xaxaxa-dev/vna/pictures/all.jpg

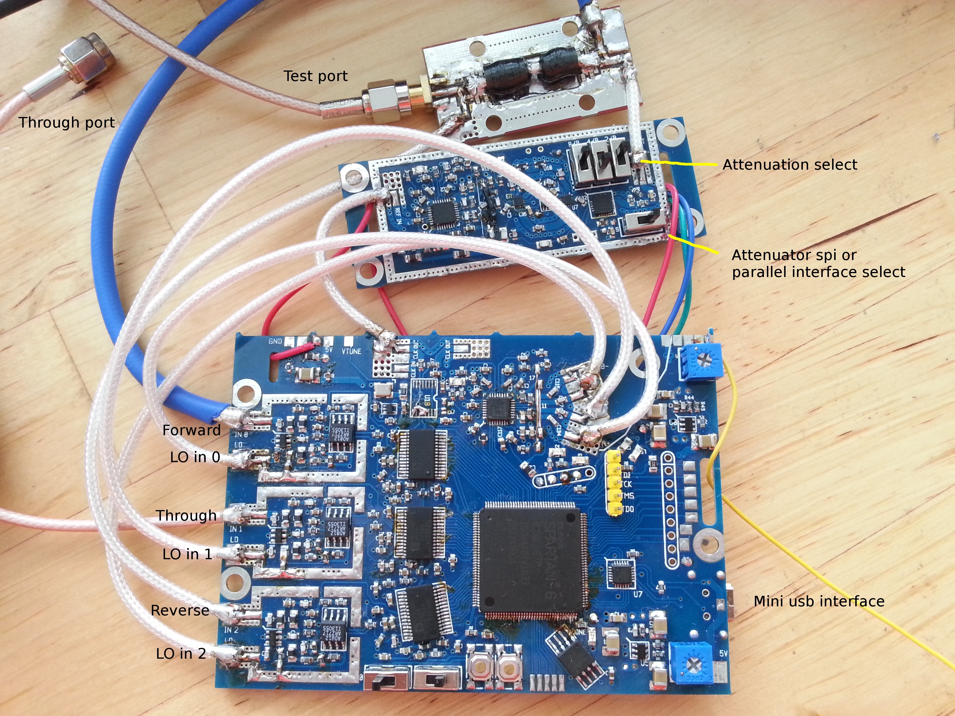
pictures/all.jpg
