xaxaxa-dev/vna/pictures/cmp_attenuator_200_2180.png

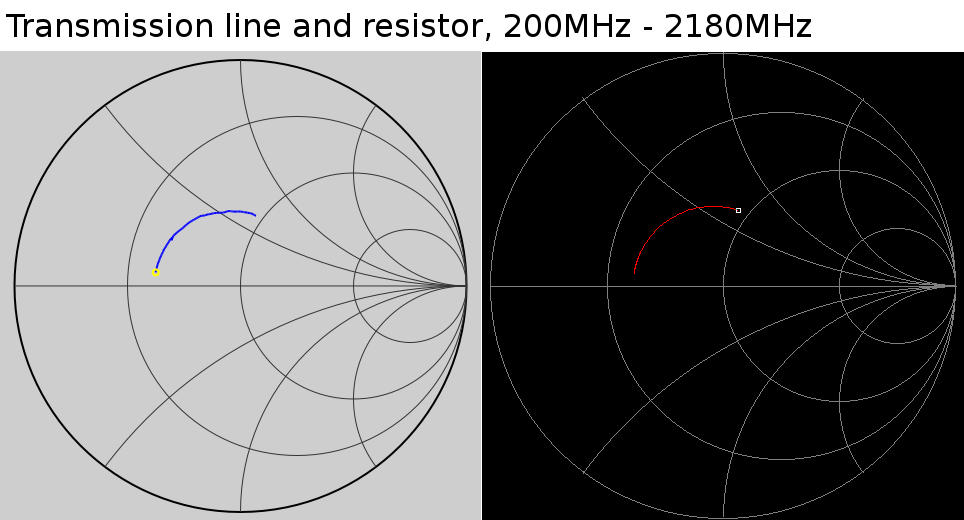
pictures/cmp_attenuator_200_2180.png
