xaxaxa-dev/vna/pictures/cmp_open_stub_200_2180.png

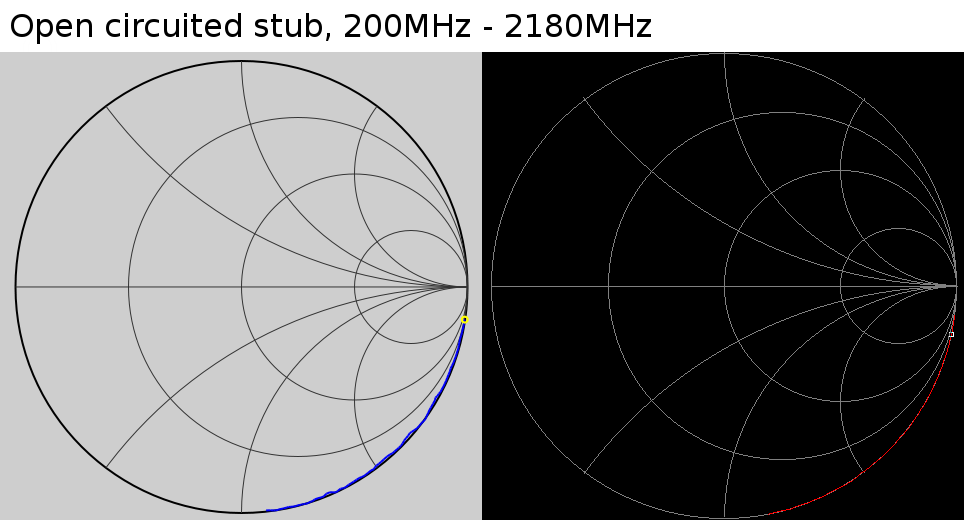
pictures/cmp_open_stub_200_2180.png
