xaxaxa-dev/vna/pictures/coupler_top.png

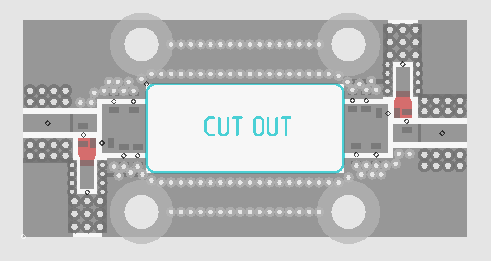
pictures/coupler_top.png
