xaxaxa-dev/vna/pictures/drift_100C_short_200_2180.png

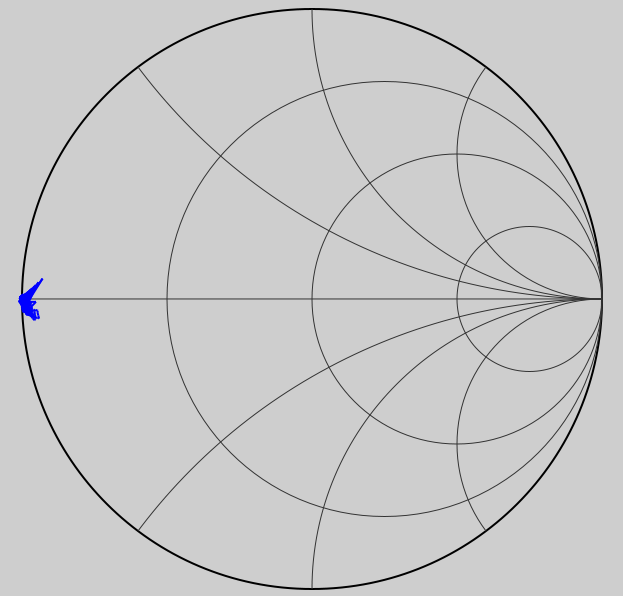
pictures/drift_100C_short_200_2180.png
