xaxaxa-dev/vna/pictures/drift_resistor_200_2180.png

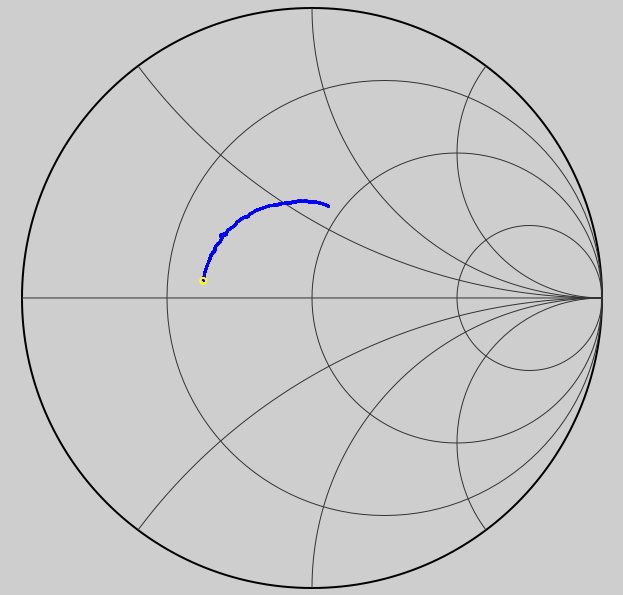
pictures/drift_resistor_200_2180.png
