xaxaxa-dev/vna/pictures/main_top.png

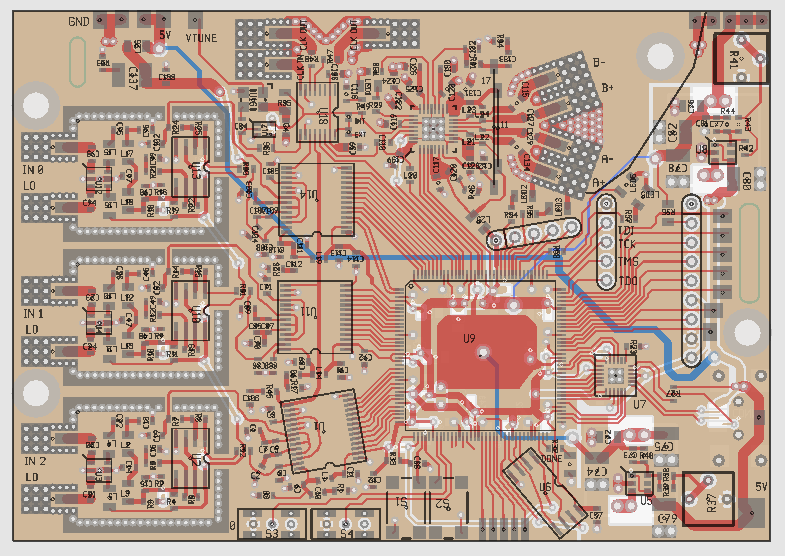
pictures/main_top.png
