xaxaxa-dev/vna/pictures/screenshot_antenna.png

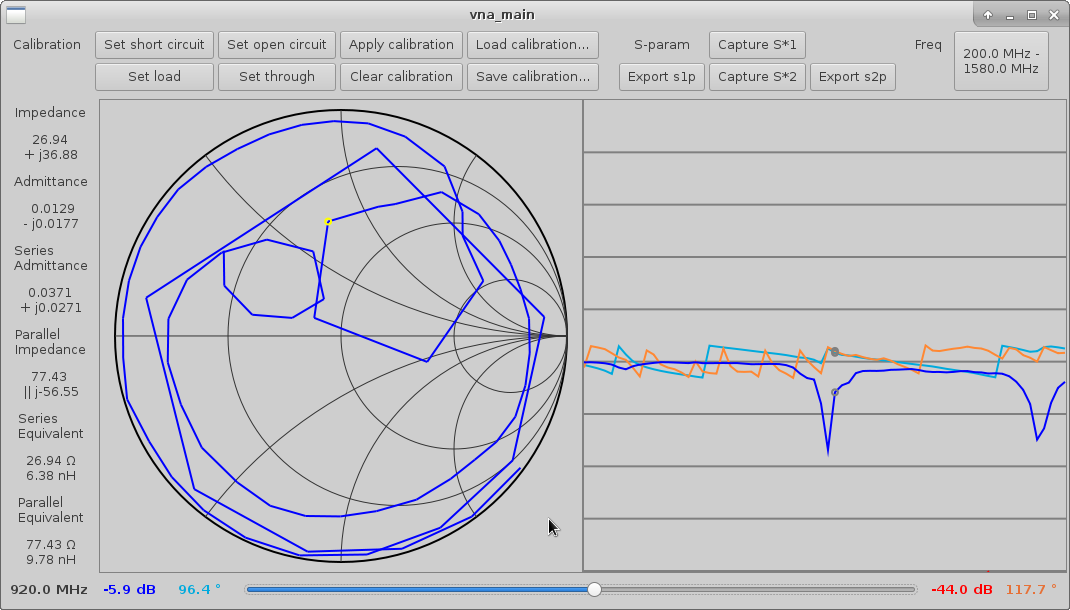
pictures/screenshot_antenna.png
