xaxaxa-dev/vna/pictures/screenshot_open_stub.png

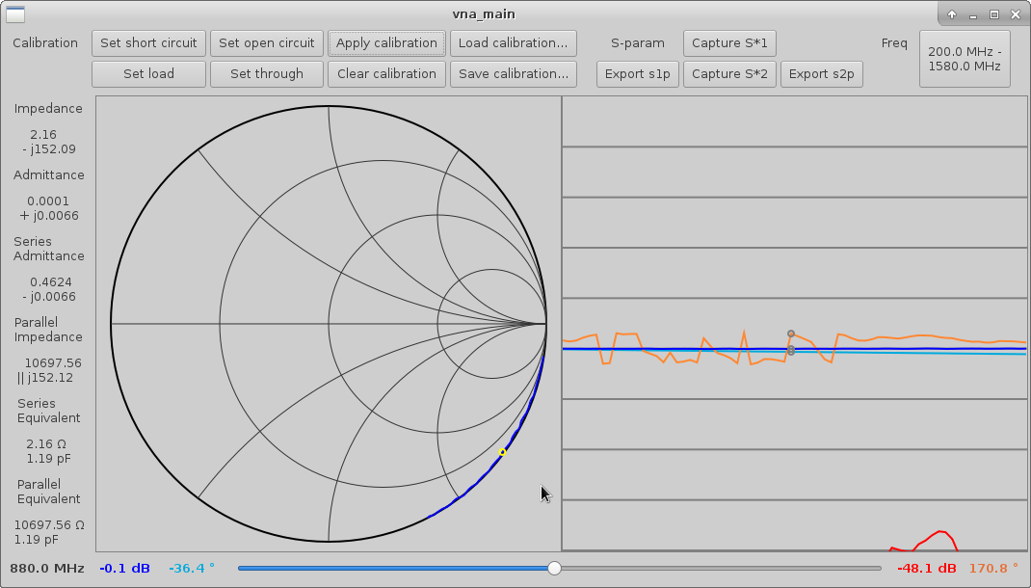
pictures/screenshot_open_stub.png
