xaxaxa-dev/vna/pictures/screenshot_pa_900.png

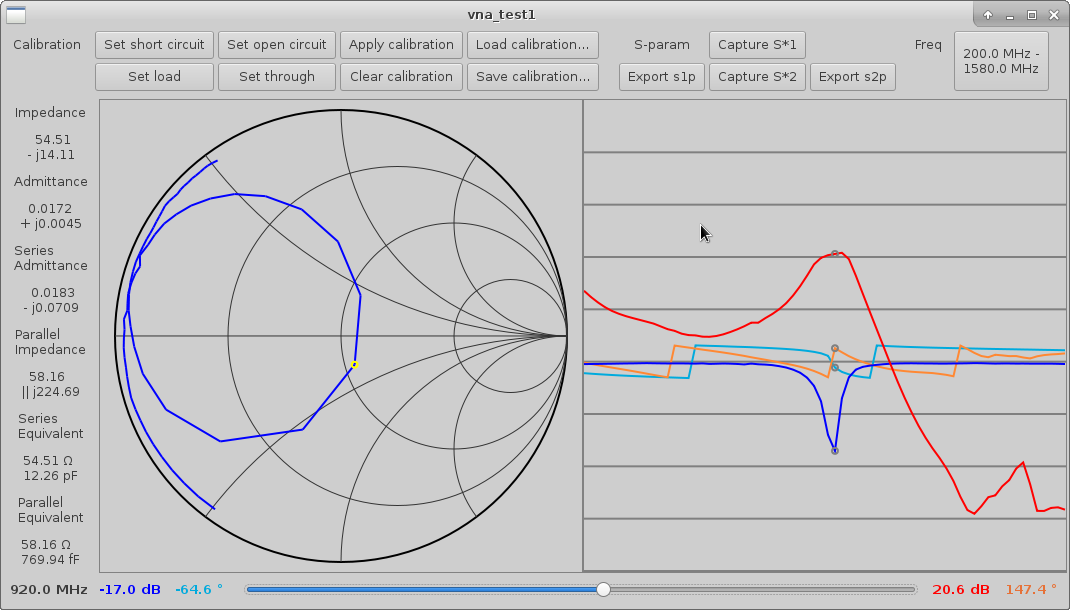
pictures/screenshot_pa_900.png
