xaxaxa-dev/vna/pictures/tx_top.png

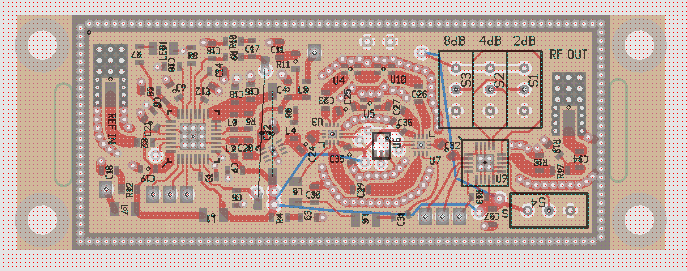
pictures/tx_top.png
