xaxaxa-dev/vna/enclosure/front_back_panel.fcstd

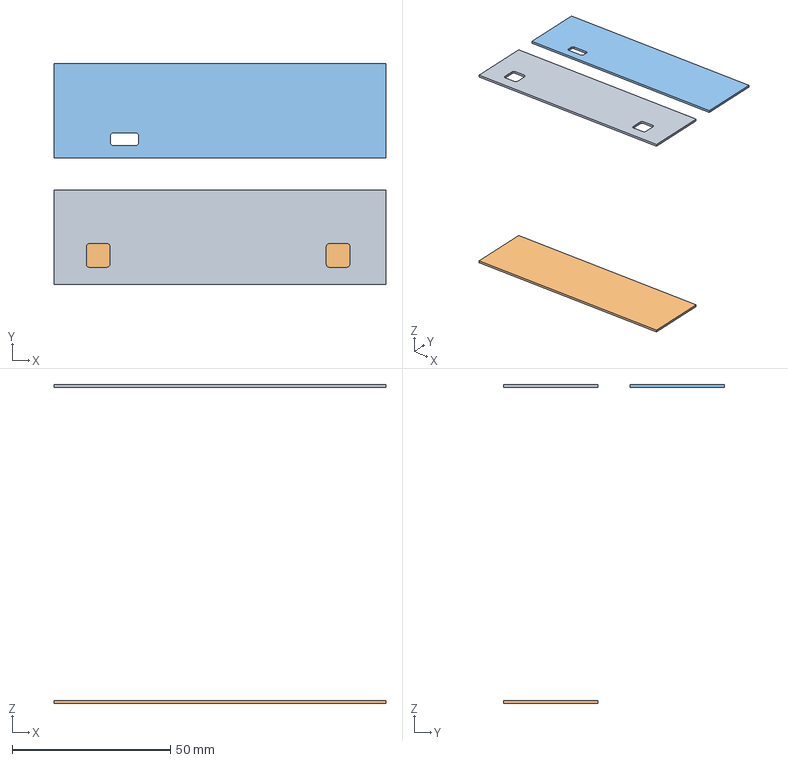
[picture p21: CAD file, 2018-03-27]
enclosure/front_back_panel.fcstd
105.0 x 70.0 x 101.0 mm
cube_back
