xaxaxa-dev/vna/(threads)

Thread 4 (2018-06-03):

HW and SW review

jkassot, 2018-06-03:
I received the XaVNA in Netherlands and tested it with a WG antenna at 2700-3000 MHz.

1. The  board seems to be of high built quality, however it appears to be a problem with the port SMA connectors and the aluminum housing. As the connectors are not secured on the enclosure, any movement of the measurement cables is transferred to the edge SMA connectors and to the board itself making the measurements jump around by 2-3 db or more. Not good for consistency. Is this issue has also been identified above as "Port Length Extension Support"? Or refers to electrical extension of the ports? It should have an easy fix at the following production batch.

2. I used the device with a Windows 10 DELL notebook. The SW is intuitive, easy to use and fast responding. However, I could not find a way to adjust the vertical scale in order to zoom into the measurements as the full dynamic range is always being displayed. That restricted the displayed accuracy to a few db. In this way could not take advantage of the measurement precision. It would be absolutely necessary to provide the option to adjust the min and the max value of the vertical scale (mainly in db and secondary in deg).

3. The measurement export function  is available only for Touchstone format and thus a specialized viewer is required to view and manipulate the measurements . It would be very helpful if there could be an output of the measurements in db and deg units as a generic Delimited Text File (DTF) that could be easily imported into Excel, MATLAB or any other application. Screen exports as .jpg or .pdf would also be helpful although there is always the workaround of screen capture.

4. The device applications would be vastly expanded if the Transmit and Receive functions could be used independently as a CW  RF generator (adjust  frequency and power) and as a calibrated Spectrum Analyzer and Peak Power meter (using the cursor). I think that almost all the code is there, just need some user interface.

Thanks for a really good product with a potential to become much better and versatile.

xaxaxa, 2018-06-04:
(1) i've noticed this issue after the first batch, and the current plan is to switch to a bulkhead sma connector that is screwed to the enclosure for later units (the full two port version already has this implemented); for the current units a workaround is to stuff some double sided tape between the board and enclosure cover plate so that it fits tightly. Thanks for bringing this up.
(2) the software is still under development and i'm working to implement those features asap
(3) i've added a todo for this one
(4) that is possible but might require updates to the firmware, since currently the device only sends values after the integrate-and-dump unit; i'm going to add a register that allows you to switch to raw adc data output, and add some facilities in libxavna to support this.

Thanks

Thread 8 (2018-06-05):

Time/Space vs Frequency VNA measurements

jkassot, 2018-06-05:
There are several cases where VNA measurements need to be taken at a single frequency over time or space instead of frequency. For example, when testing a multi-element (phased array) antenna and need to check amplitude and phase (S21) from feed point to each element and/or reverse.
Would it be possible to select first a single Frequency and Power setting and then select:
 (a)  either a Time period of measurement (in Seconds)
or (b) a number of discrete measurement steps (and advance manually from one to next) ?
You would then need to rescale the x-axis to accommodate the selected time period (in sec) or the number of discrete steps.
You could also ask user  specify the number of samples to average at each step.
Finally, save the measurement to a text delimited file format for further processing, like Near-to-Far field transformation by MATLAB.
If such a measurement mode could be possible, would open  for xaVNA a whole new range of applications that are not found at any low-cost VNAs.

xaxaxa, 2018-07-08:
The way the UI code is structured right now it would be difficult to implement an axis other than frequency, but I think this is a good use case for libxavna; you can use the C api: https://github.com/xaxaxa-dev/vna/tree/master/libxavna and just skip frequency sweeping. For the plotting there is a minimal example using QT graphs here: https://github.com/xaxaxa-dev/vna/tree/master/vna_diagtool which can be a starting point

cbalint13, 2018-11-22:
I believe that by exporting some API of xaVNA to some higer level languages e.g. python would be wiser and would cover more universal scenarios.

  Some small script examples (e.g. python)  would allow users to craft their own custom workflow and export measurments as they wish. Perhaps even connect with libs like matplotlib for graph out custom data in any flavour.

  I am willing to contribute a wrapper to python for some basic functions with some basic ilustrative usage examples but need first cmake infrastructure to ease the process of wrapping. See PR #17.

jkassot, 2019-05-16:
Are there any developments with regards to a Python wrapper for the C/C++ libraries? That would help a lot.

cbalint13, 2019-05-16:
On Thu, May 16, 2019 at 5:04 PM jkassot <notifications@github.com> wrote:

> Are there any developments with regards to a Python wrapper for the C/C++
> libraries? That would help a lot.
>

Hi Jkassot,

I work in progress on that, ETA ~1 month and will be done.

jkassot, 2019-05-16:
Fantastic!
Thanks!

On Thu, May 16, 2019 at 4:30 PM Balint Cristian <notifications@github.com>
wrote:

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

jkassot, 2019-08-02:
Any update on the python library by cbalint13?

Thread 15 (2018-10-27):

any way to stretch low end down to ~75MHz?

akohlsmith, 2018-10-27:
This is a fascinating project, thank you for your hard work!

I am wondering if it is possible to tweak the component selection to extend the low end down to include the broadcast FM range (88-108MHz), as I'd like to experiment with some filters in that area. Is such a thing possible with this design?

xaxaxa, 2018-10-31:
It's possible; the two synthesizers (adf4350) need to be replaced with adf4351 which will bring lower frequency limit down to 35MHz. There are plans to switch to adf4351 by default in an upcoming hardware revision.

kf4mot, 2018-12-07:
Any estimate on when the 35MHz version will be available?

xaxaxa, 2018-12-09:
@kf4mot probably by Q2 2019

Closed 2018-10-31.

Thread 16 (2018-10-31):

Directional coupler detail

akohlsmith, 2018-10-31:
Is there any documentation on the directional coupler? It looks like some kind of large ferrite over part of the board, but I can't see any information other than that the PCB has a stripline.

xaxaxa, 2018-11-03:
it's a resistive bridge plus a balun, similar to the coupler used here: http://hforsten.com/improved-homemade-vna.html

Thread 19 (2018-12-13):

Any plans for a version with increased freq?

kf4mot, 2018-12-13:
Ideally up to 6 GHz+

xaxaxa, 2018-12-20:
None at the moment, but there is another open source VNA design that can go up to 6GHz: http://hforsten.com/improved-homemade-vna.html

kf4mot, 2018-12-21:
Or this may be a viable solution if freq. is scaled up. I probably even have most of the mixers, oscillator, and filters in my junk box.

Closed 2018-12-20.

Thread 20 (2019-01-14):

Crash when applying SOLT UXYZ or modified UXYZ calibration

Rodentia, 2019-01-14:
App crash on Mac and Windows when applying SOLT UXYZ or modified UXYZ calibration data.

Process:               vna_qt [62307]
Path:                  /Applications/vna_qt.app/Contents/MacOS/vna_qt
Identifier:            vna_qt
Version:               0
Code Type:             X86-64 (Native)
Parent Process:        ??? [1]
Responsible:           vna_qt [62307]
User ID:               501

Date/Time:             2019-01-14 15:35:06.379 -0800
OS Version:            Mac OS X 10.14.1 (18B2107)
Report Version:        12
Bridge OS Version:     3.1 (16P1582)
Anonymous UUID:        874C6354-2402-A038-F2C8-536EF4AFFF94

Sleep/Wake UUID:       1F95E6F7-4F14-4962-8174-6D0DD3298828

Time Awake Since Boot: 1900000 seconds
Time Since Wake:       26000 seconds

System Integrity Protection: enabled

Crashed Thread:        0  Dispatch queue: com.apple.main-thread

Exception Type:        EXC_CRASH (SIGABRT)
Exception Codes:       0x0000000000000000, 0x0000000000000000
Exception Note:        EXC_CORPSE_NOTIFY

Application Specific Information:
abort() called
terminating with uncaught exception of type std::runtime_error: matrix rank is not full! should be 4, is 3

Thread 0 Crashed:: Dispatch queue: com.apple.main-thread
0   libsystem_kernel.dylib        	0x00007fff7eeccb86 __pthread_kill + 10
1   libsystem_pthread.dylib       	0x00007fff7ef82c50 pthread_kill + 285
2   libsystem_c.dylib             	0x00007fff7ee361c9 abort + 127
3   libc++abi.dylib               	0x00007fff7c4b8231 abort_message + 231
4   libc++abi.dylib               	0x00007fff7c4b83b5 default_terminate_handler() + 241
5   libobjc.A.dylib               	0x00007fff7dcc1c8f _objc_terminate() + 105
6   libc++abi.dylib               	0x00007fff7c4c3dfe std::__terminate(void (*)()) + 8
7   libc++abi.dylib               	0x00007fff7c4b786e __cxa_rethrow + 99
8   libobjc.A.dylib               	0x00007fff7dcbfb6e objc_exception_rethrow + 40
9   com.apple.CoreFoundation      	0x00007fff51baaac3 CFRunLoopRunSpecific + 618
10  com.apple.HIToolbox           	0x00007fff50e43b35 RunCurrentEventLoopInMode + 293
11  com.apple.HIToolbox           	0x00007fff50e43774 ReceiveNextEventCommon + 371
12  com.apple.HIToolbox           	0x00007fff50e435e8 _BlockUntilNextEventMatchingListInModeWithFilter + 64
13  com.apple.AppKit              	0x00007fff4f0ffeb7 _DPSNextEvent + 997
14  com.apple.AppKit              	0x00007fff4f0fec56 -[NSApplication(NSEvent) _nextEventMatchingEventMask:untilDate:inMode:dequeue:] + 1362
15  com.apple.AppKit              	0x00007fff4f0f8cb9 -[NSApplication run] + 699
16  libqcocoa.dylib               	0x00000001050873ad 0x10505e000 + 168877
17  org.qt-project.QtCore         	0x0000000102fa9a72 QEventLoop::exec(QFlags<QEventLoop::ProcessEventsFlag>) + 418
18  org.qt-project.QtCore         	0x0000000102fae692 QCoreApplication::exec() + 402
19  com.yourcompany.vna-qt        	0x0000000101f7a94f main + 383
20  libdyld.dylib                 	0x00007fff7ed8e08d start + 1

Thread 1:: com.apple.NSEventThread
0   libsystem_kernel.dylib        	0x00007fff7eec6c2a mach_msg_trap + 10
1   libsystem_kernel.dylib        	0x00007fff7eec7174 mach_msg + 60
2   com.apple.CoreFoundation      	0x00007fff51babda2 __CFRunLoopServiceMachPort + 337
3   com.apple.CoreFoundation      	0x00007fff51bab2f1 __CFRunLoopRun + 1654
4   com.apple.CoreFoundation      	0x00007fff51baaa28 CFRunLoopRunSpecific + 463
5   com.apple.AppKit              	0x00007fff4f108add _NSEventThread + 160
6   libsystem_pthread.dylib       	0x00007fff7ef80339 _pthread_body + 126
7   libsystem_pthread.dylib       	0x00007fff7ef832a7 _pthread_start + 70
8   libsystem_pthread.dylib       	0x00007fff7ef7f445 thread_start + 13

Thread 2:: Dispatch queue: NSCGSDisableUpdates
0   libsystem_kernel.dylib        	0x00007fff7eec6c2a mach_msg_trap + 10
1   libsystem_kernel.dylib        	0x00007fff7eec7174 mach_msg + 60
2   com.apple.SkyLight            	0x00007fff77cb7c37 CGSUpdateManager::enable_updates_common() + 539
3   com.apple.SkyLight            	0x00007fff77c5b07f CGSUpdateManager::enable_update(unsigned long long) + 317
4   libdispatch.dylib             	0x00007fff7ed3ed53 _dispatch_call_block_and_release + 12
5   libdispatch.dylib             	0x00007fff7ed3fdcf _dispatch_client_callout + 8
6   libdispatch.dylib             	0x00007fff7ed46124 _dispatch_lane_serial_drain + 618
7   libdispatch.dylib             	0x00007fff7ed46bdc _dispatch_lane_invoke + 388
8   libdispatch.dylib             	0x00007fff7ed4f090 _dispatch_workloop_worker_thread + 603
9   libsystem_pthread.dylib       	0x00007fff7ef7f63c _pthread_wqthread + 409
10  libsystem_pthread.dylib       	0x00007fff7ef7f435 start_wqthread + 13

Thread 3:
0   libsystem_pthread.dylib       	0x00007fff7ef7f428 start_wqthread + 0
1   ???                           	0x0000000054485244 0 + 1414025796

Thread 4:
0   libsystem_kernel.dylib        	0x00007fff7eec88a6 read + 10
1   libxavna.0.dylib              	0x0000000101fd3d09 readValue2(int, int) + 857
2   libxavna.0.dylib              	0x0000000101fd41bb xavna_default::read_values_raw(double*, int) + 91
3   libxavna.0.dylib              	0x0000000101fd5928 xaxaxa::VNADevice::_mainThread() + 408
4   libxavna.0.dylib              	0x0000000101fd5629 xaxaxa::_mainThread_(void*) + 9
5   libsystem_pthread.dylib       	0x00007fff7ef80339 _pthread_body + 126
6   libsystem_pthread.dylib       	0x00007fff7ef832a7 _pthread_start + 70
7   libsystem_pthread.dylib       	0x00007fff7ef7f445 thread_start + 13

Thread 5:
0   libsystem_pthread.dylib       	0x00007fff7ef7f428 start_wqthread + 0
1   ???                           	0x0000000054485244 0 + 1414025796

Thread 6:
0   libsystem_pthread.dylib       	0x00007fff7ef7f428 start_wqthread + 0
1   ???                           	0x0000000054485244 0 + 1414025796

Thread 0 crashed with X86 Thread State (64-bit):
  rax: 0x0000000000000000  rbx: 0x000000011149f5c0  rcx: 0x00007ffeedca4988  rdx: 0x0000000000000000
  rdi: 0x0000000000000307  rsi: 0x0000000000000006  rbp: 0x00007ffeedca49c0  rsp: 0x00007ffeedca4988
   r8: 0x00007ffeedca4848   r9: 0x00007ffeedca4a20  r10: 0x0000000000000000  r11: 0x0000000000000206
  r12: 0x0000000000000307  r13: 0x0000003000000008  r14: 0x0000000000000006  r15: 0x000000000000002d
  rip: 0x00007fff7eeccb86  rfl: 0x0000000000000206  cr2: 0x00007fffb1bc1188

Logical CPU:     0
Error Code:      0x02000148
Trap Number:     133

xaxaxa, 2019-01-19:
Are you in T/R mode? The error message "matrix rank is not full" implies the measurements are not linearly independent, which can happen if you e.g. try to calibrate port 2 when in T/R mode.

Thread 24 (2019-04-16):

Improve the operating range

kapil-iitk, 2019-04-16:
How to improve the  VNA operating range up to 4 or 5 GHz?

hugen79, 2019-04-18:
Replace ADF4351 with MAX2871，is feasible？

xaxaxa, 2019-04-18:
MAX2871 has sourcing issues last time I checked, but I'm looking into it.

Closed 2019-04-18.

Thread 25 (2019-05-06):

Timing for new batch available for order

deandob, 2019-05-06:
Hi,

I sent an email to the email at the 'contact us' page on the xaxax web site but didn't hear back. Another batch for sale was apparently due in April, have these arrived or sold out? Do let me know how I can order an xaVNA T/R two port.

Thanks - and nice work with the development of this.

Regards,
Dean

xaxaxa, 2019-05-07:
Hi,

Sorry, it looks like your email landed in my spam folder (I'll be sure to check it more often).
The boards have arrived but there was a delay with the enclosure. I think this should be sorted in a week and it will be available for order.

Thanks

deandob, 2019-05-07:
Great, do post back here when its available for payment. Thanks.

deandob, 2019-05-19:
I see these are now available from your website, I have placed an order to ship to Australia. Thanks.

satfan52, 2019-06-16:
Hello everybody,

I want to publicly  thank Cary for giving me the opportunity to assemble   "the 2 port  version" of his Xavna product. I can not do it on kickstarter since I did not buy a device so I decided to do it here instead.

Initially, I wanted to buy a two port version but since it was not yet available commercially Cary offered me to assemble one from one of his spare PCB  that was already half populated . After installing the additional components needed and after flashing the firmware, I ended up with a fully functioning device. Even if my device was not as proffesionally assembled as the ones build in industrial environments, I am very happy with the final result. My device meets the formal specification of the two port Xavna, actually it even exceeds them in terms of frequency range and dynamic range. Cary helped me solved the issues that I encountered and I especially want to praise the quality his support (as well as his patience and his  availability). Please rest assured that if you buy some of Cary's products you will be offered top quality support if you need it.

Here are a few pictures of the measurements taken with the two port VNA that I assembled myself using the information available here in this github repository

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

deandob, 2019-06-17:
My VNA from the new batch arrived a week ago, well packed and well assembled, thank you.
I'm using it to tune a 915Mhz antenna but struggling a bit with setting up and measuring, more my lack of understanding how measure with a VNA although a user guide would have helped (have worked out how to calibrate so far). I'm also unclear how to use the 2nd port (I have the T/R version) for measurement. Stuff found on google is helping but if someone has a definitive quide to antenna tuning with a VNA please pass on a link.

satfan52, 2019-06-17:
I am not familiar with the T/R version as I own the two port one. However  if you are using the VNA in reflexion mode to tune an antenna, you only need port 1 for making the measurement (after doing the SOLT calibration)

If you decide to use an external rf bridge/coupler  with a simple SOL calibration , then you will need to use the two ports obviosuly,  but  I don't see why you would want to do that.

If you want to tune the antenna, the goal is to get it to an swr of 1 I assume. You can display the swr curve and you can look on the smith chart what is the impedance of the antenna. If you see it is too inductive you can short it, if it is too capacitive you can extend it (for example). If the impedance is ohmic but too low or too high compared to 50 ohm, then you need to match your antenna one way or another to 50 ohm  using gamma match, ballun etc...This  smith chart will only help you see what is the effect of your matching and can help you calculate the network  required  to do the matching. This is not about the software, people have spent the best years of their lives on the subject, you will find plenty of info on google

deandob, 2019-06-18:
Thank you satfan52, helpful.
Would be useful if someone could explain how to use the second T/R (transmit/receive?) port and why its different to a proper 2 port (eg. can we measure S21,S22 etc.)?

satfan52, 2019-06-18:
You can use the second port to measure the Gain, loss and phase shift of 4
port DUT like an amplifier or a filter for instance. If you build an rf
transformer for Powe lr amp or a balun for your antenna you can measure it
too, for instance to verify that the impedance transforming ratio is the
right one and to check its bandwidth

Antennas are two port DUTs so you do not need the second port on the T\R
model, only port 1.

If you connect the 4 port DUT between port 1 and port 2, you will be able
to see the input  impedance on the Smith Chart on the left and on the right
side you can for instance display the frequency response  of the Gain of
the amplifier  or the loss of the filter (Mag S21 and Arg S21). The key
point is Is that you can measure transmission related info (S21) as well as
reflexion related info (S11) at the same time, that is why it is called a
T/R!  I have another VNA that is not T/R and it is a pain in the neck as I
need to different calibration procedures for reflection and transmission
measurements.

Seeing  both gain and impedance at the same time  is useful as you can see
for instance how an swr improvement at the input of amp translates into a
higher gain since less energy is reflected towards the generator

With a T/R VNA, if you want to measure the output impedance of the 4 port
DUT  and the Gain or loss  in the opposite direction do from output to
input, then  you need to physically reverse the DUT: so its input is
connected to port 2 instead of port 1 and its output to port 1 instead of
port 2.

With the two port VNA I don't need to do to this reversing because the two
ports are active in the very same way, with one measurement I get
everything related to the input and output  input of the 4 port DUT. That
is especially useful for making measurements of non symmetrical devices
like an amp, a mixer or an rf transformer for instance. I can visualise how
changes of the output impedance of an amp affects the input impedance due
to the Miller effect. There are of course other advantages of using a 2
port VNA over a T/R one.

Hope that helps
Regards

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

deandob, 2019-06-19:
Useful thanks satfan52.
The VNA has already earnt its keep, I'm developing a LoRa solution and can see that the helix antenna we are using has quite narrow bandwidth that is just outside our frequency when its inside its box, and with some adjustments to the antenna layout and the matching circuit the gain has increased significantly!

Thread 26 (2019-06-17):

Part numbers for U204, U205 and U206

NiklasFauth, 2019-06-17:
Hey,

I'm missing the part numbers for these filters. I guess one of them is LP0603A2140ANTR and another is LP0603A0947ANTR, but which filter is used where?

Also, there is a mismatch between PE4302 in the schematic and PE4312 in the description and AP4329 in the schematic and AP4319 in the BOM.

I would love to get some clarification, and ideally an up-to-date BOM for main2_2. Thanks!

Best
Niklas

xaxaxa, 2019-06-17:
In gschem if you double click on the component you will see the hidden attributes that say U204 is LP0603A0947 for example. The real part numbers used in production are in the main2_2.mapping.csv file, which is used by a script to generate the production BOM.

NiklasFauth, 2019-06-18:
I haven't used gEDA before, thanks for the clearification!

Best,
Niklas

Closed 2019-06-18.

Thread 28 (2019-10-12):

Spectrum Analyzer mode

jkassot, 2019-10-12:
Would it be possible to add a Spectrum Analyzer function/mode?
Just scan the desired band and display the input of Rx port.
Maybe could include a "Thru" measurement to calibrate the receiver for power measurement for the Band that will be scanned.

satfan52, 2019-11-21:
Yes, it would be really great if we could also use the XaVNA as a sweep based spectrum analyser.
Though the current sweeping speed would have to be increased as for spectrum analyser it must be much faster than for a VNA (for obvious reasons). We would also need to be able to contrôle the Raw Bandpass filter and go down to resolutions of 1khz if not 100hz for narrow bandwidth signal analysis.

garangstore, 2025-04-05:
A [spectrum analyzer](https://www.garangstore.com/spectrum-analyzer) measures the magnitude of an input signal versus frequency within the full frequency range of the instrument. The primary use is to measure the power of the spectrum of known and unknown signals. The input signal that most common spectrum analyzers measure is electrical; however, spectral compositions of other signals, such as acoustic pressure waves and optical light waves, can be considered through the use of an appropriate transducer. Spectrum analyzers for other types of signals also exist, such as optical spectrum analyzers which use direct optical techniques such as a monochromator to make measurements.
