xaxaxa-dev/vna/enclosure/drawing20180327.pdf

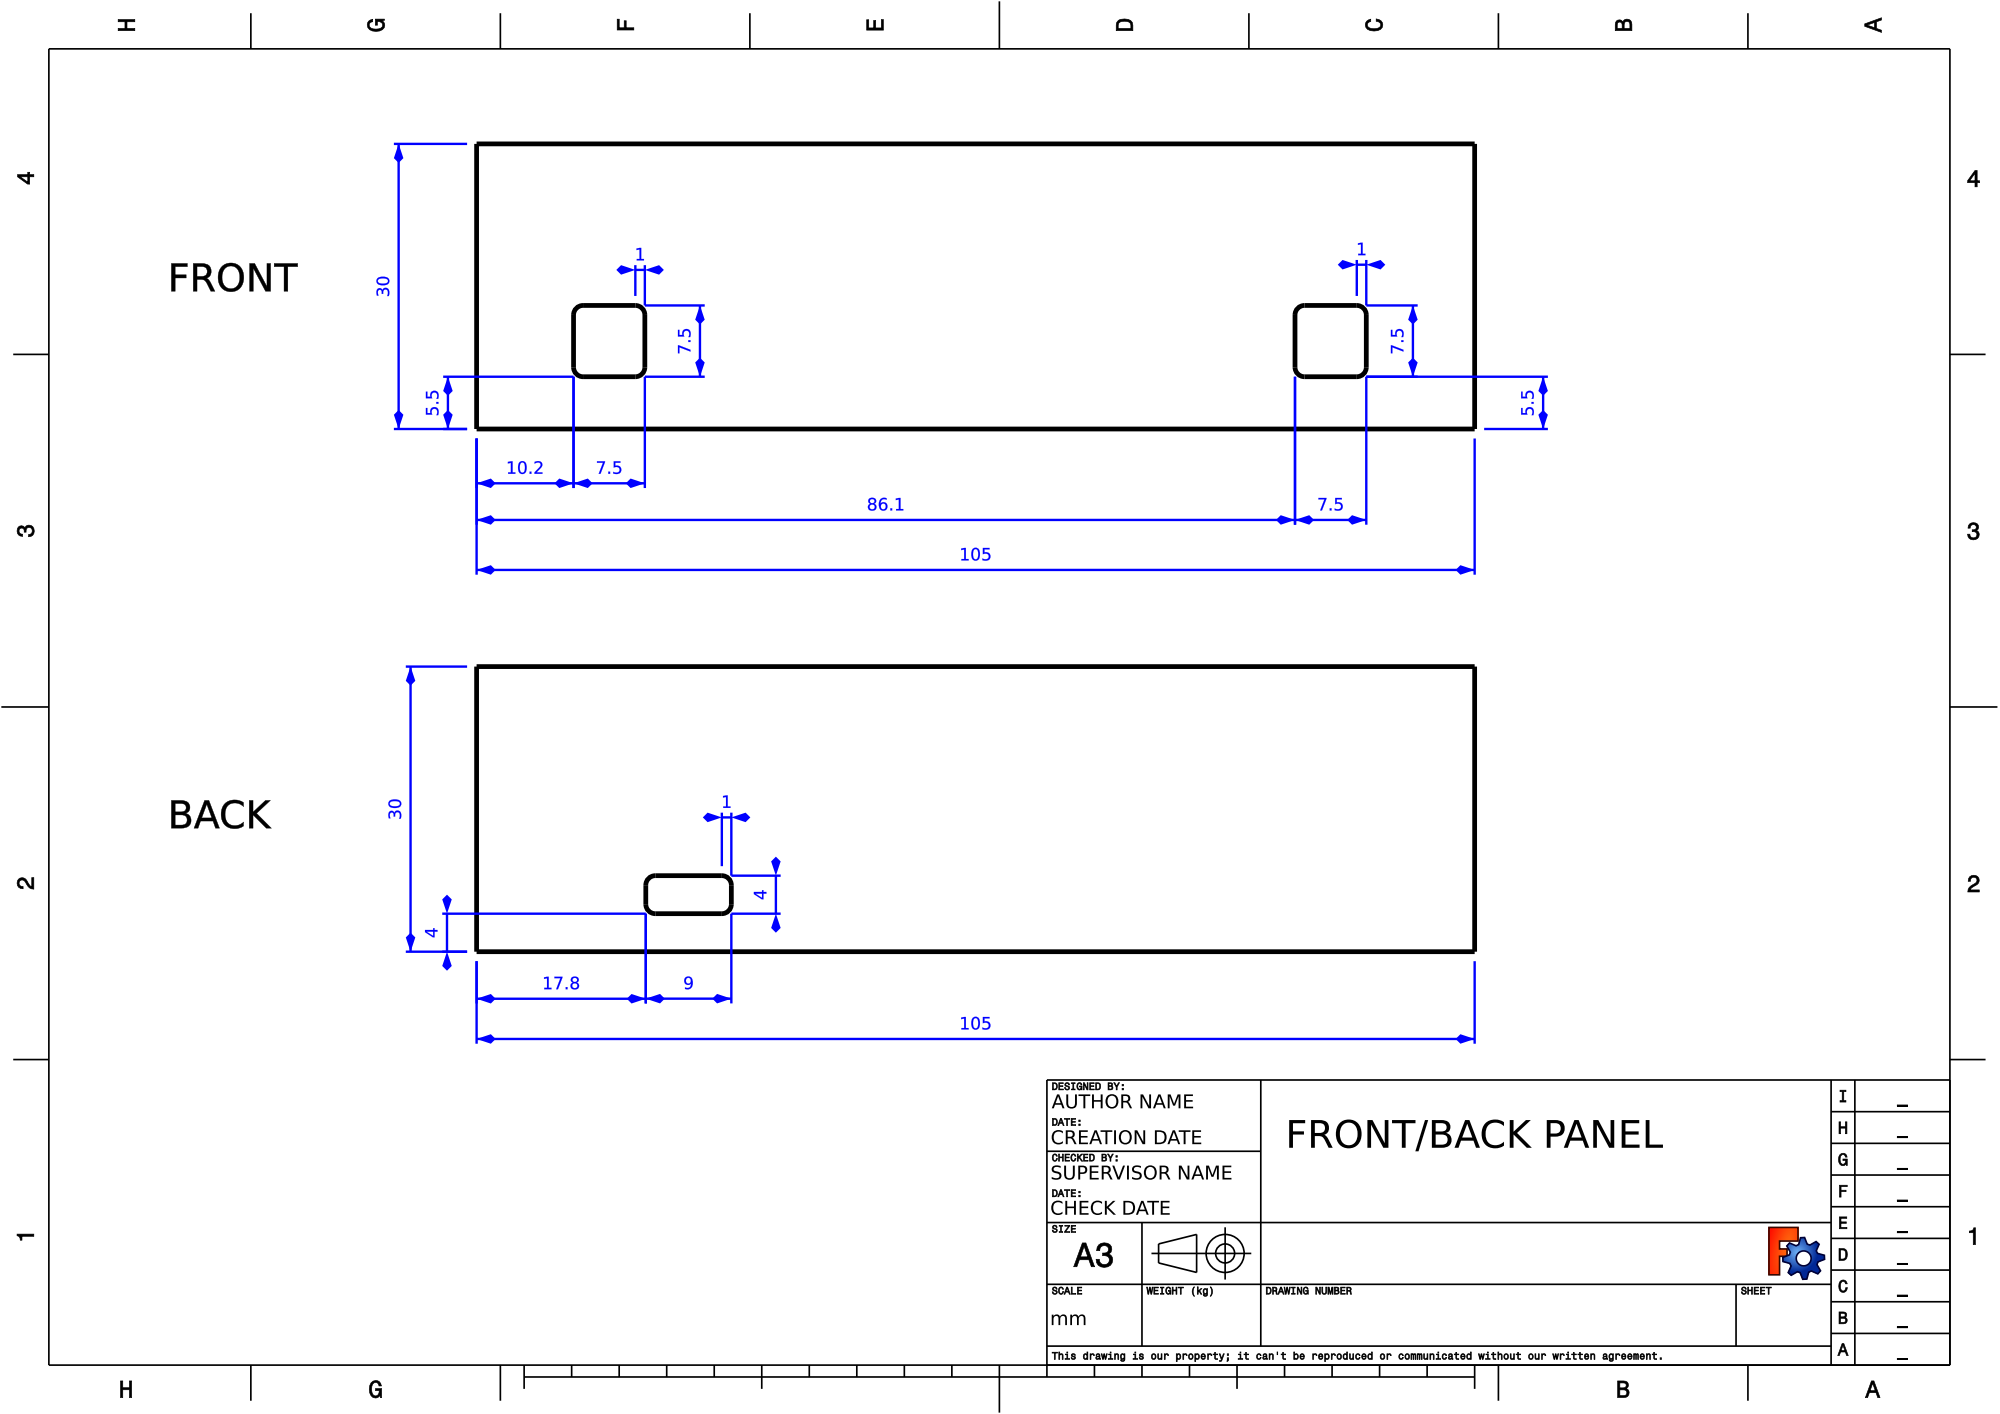
[picture p22: page 1]
