xaxaxa-dev/vna/enclosure/drawing.pdf

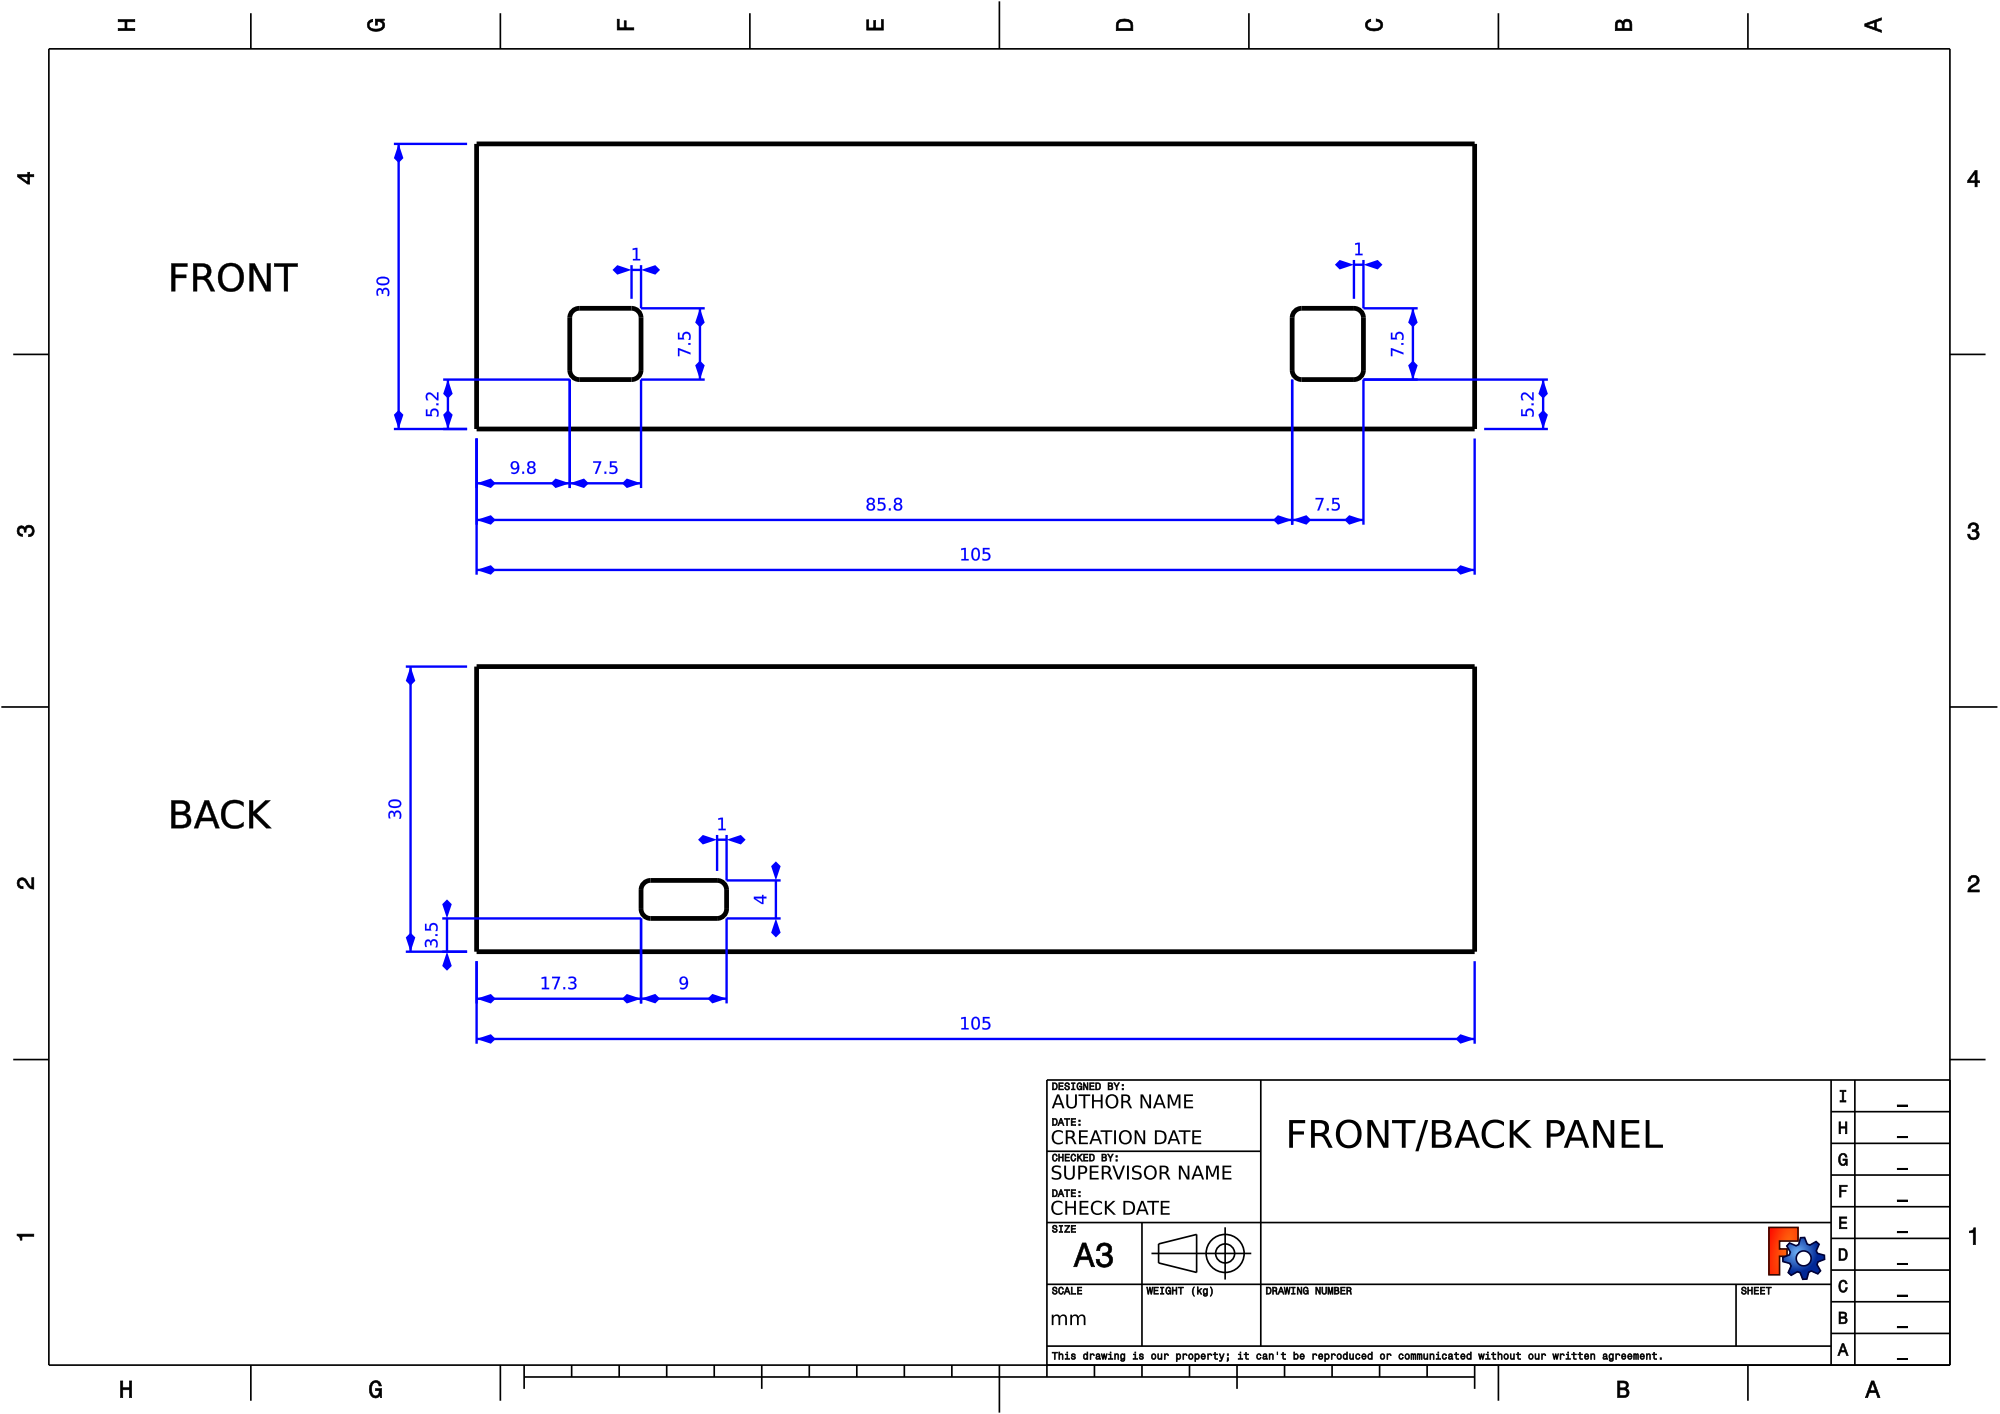
[picture p23: page 1]
