xaxaxa-dev/vna/pcb/bb_amp_2.asc

C1: cap; 1µ
C3: cap; 470p
C4: cap; 100µ
C5: cap; 1µ
C6: cap; 1µ
C7: cap; 330p
C8: cap; 1µ
C10: cap; 30p
L1: ind; 4.7µ; Rser=3
L2: ind; 4.7µ; Rser=3
R1: res; 220
R2: res; 10k
R3: res; 22k
R4: res; 100
R5: res; 1k
R6: res; 100
R7: res; 470
R8: res; 1k
R9: res; 220
R10: res; 1k
U1: ad812
U2: ad812
V1: voltage; 5
V3: voltage; SINE(0 0.01 3000k); AC 10
Named nets: 0
;tran 0 50u 0 2n
;step temp list -20 0 20 40 60
.inc C:\\Program Files\\LTC\\LTspiceIV\\lib\\sub\\2sc3357.sub
.inc C:\\Program Files\\LTC\\LTspiceIV\\lib\\sub\\bfg425w.sub
.ac oct 10 1k 100000k
