xaxaxa-dev/vna/pcb/pwr_filtering.asc

C1: cap; 100µ
C2: cap; 20µ
C3: cap; 470n
C4: cap; 10µ
C5: cap; 10µ
C6: cap; 10µ
I1: current; ""; AC 1
I2: current; ""; AC 0
I3: current; ""; AC 0
L1: ind; 10µ
L2: FerriteBead; 3.3µ; Ipk=0.6 Rser=0.23 Rpar=1050 Cpar=680f mfg="Wurth Elektronik" pn="742 792 662"
L3: FerriteBead; 3.3µ; Ipk=0.6 Rser=0.23 Rpar=1050 Cpar=680f mfg="Wurth Elektronik" pn="742 792 662"
R1: res; 2
R2: res; 1
R3: res; 1
V1: voltage; ""; AC 0
V2: voltage; ""; AC 1
V3: voltage; ""; AC 1
Named nets: 0
.ac oct 10 100 1000000
