xaxaxa-dev/vna/pcb/bb_amp.asc

C1: cap; 100n
C2: cap; 470p
C3: cap; 470p
C4: cap; 100µ
C5: cap; 1µ
C6: cap; 1µ
C7: cap; 470p
C8: cap; 1µ
C9: cap; 1µ
C10: cap; 51p
L1: ind; 4.7µ; Rser=3
L2: ind; 4.7µ; Rser=3
L3: ind; 2.2µ
R1: res; 82
R2: res; 22k
R3: res; 220
R4: res; 50
R5: res; 1k
R6: res; 10k
R7: res; 470
R8: res; 1k
R9: res; 220
R10: res; 470
U1: ad812
U2: ad812
V1: voltage; 5
V2: voltage; SINE(0 0 4000k)
V3: voltage; SINE(2.5 0.025 5000k); AC 2
Named nets: 0
;tran 0 50u 0 2n
;step temp list -20 0 20 40 60
.inc C:\\Program Files\\LTC\\LTspiceIV\\lib\\sub\\2sc3357.sub
.inc C:\\Program Files\\LTC\\LTspiceIV\\lib\\sub\\bfg425w.sub
.ac oct 10 1k 100000k
