xaxaxa-dev/vna/(list of files, drawings)

Other design files:
pcb/coupler.pcb
pcb/main2.pcb
pcb/main2_2.pcb
pcb/main3.pcb
pcb/main3_2.pcb
pcb/main.pcb
pcb/packages/0402_s.pcb
pcb/tx.pcb
pcb/vna_tester.pcb
