xaxaxa-dev/vna/(commit log)

2017-09-09 add pcb design files
    * vna main board
    * signal generator board
    * directional coupler board
    [ad9200.csv, adf4350.csv, ap3419.csv, cmy211.csv, coupler.pcb, main.pcb, main.sch, nc7s04.csv]
2017-09-09 pcb: add missing footprints and symbols
    [bgs14ga14.csv, lp0603.csv, pe4302.csv, trf37a75.csv]
2017-09-09 pcb: add readme
2017-09-10 add calibration standards picture to readme
2017-09-26 iteration 2 WIP
    [main2.pcb, main2.sch]
2017-09-26 modify footprints for DFM
    * make the footprints more friendly for automated assembly
    * correct the orientation of the footprint, so that generated xy file
    can have the right rotation values
2017-09-26 revise a few component values in iteration 1 schematics
    [main.sch, tx.sch]
2017-09-28 add screenshot of persistence plot with 100*C heat gun
2017-09-29 add screenshot of temperature drift measuring resistor + tline
2017-11-13 pcb: revise a few footprints and symbols
    [lp0603.csv]
2017-11-13 pcb: main2: add reference clock in; fix up all shield footprints
    * fix spi flash footprint
    * revise power filtering near mixers
    * minor changes to coupler
    [main2.pcb, main2.sch]
2017-11-27 vna_main.C: small changes to support board version 2
    * configure programmable attenuator
    * swap data array index 3 and 4
2017-12-14 pcb 20171214
    [main2.mapping.csv, main2.pcb, main2.sch]
2017-12-16 vhdl: top level logic for iteration 2 board
2017-12-17 sw: move calibration functions to library
2017-12-21 pcb: add a clock output pad
    [main2.pcb, main2.sch]
2018-01-15 pcb: add version 2 board
    main changes from version 1:
    * redesigned receiver sections to use ad8342 mixer
    [ad8342.csv, main2_2.mapping.csv, main2_2.pcb, main2_2.sch]
2018-01-15 add tester pcb
    [vna_tester.pcb, vna_tester.sch]
2018-01-15 rotate footprints to match jlc smt's standard orientations
2018-01-15 switch to 0.01MHz synthesizer resolution; add rf filter select register
2018-01-25 pcb: main2_2: footprint changes
    [main2_2.pcb, main2_2.sch]
2018-01-25 pcb: main2_2: fix bom mappings file
    [main2_2.mapping.csv]
2018-01-25 pcb: new footprint files
2018-02-04 pcb: main2_2: minor fixes
    silkscreen moves
    [main2_2.pcb]
2018-02-04 tester: show all errors in the event of fail
    [main.C, ui.H]
2018-02-19 tester: add missing files
    [platform.H, platform_opi.C]
2018-02-19 pcb: final pcbs
    [main.sch, main2.mapping.csv, main2.pcb, main2.sch, main2_2.pcb, main2_2.sch]
2018-02-26 vna_qt: basic features now working
    * smith chart & graphs
    * device access
    * SOL calibration
    * markers
2018-02-28 fix footprint files to correspond to those used in the pcb
2018-03-04 vna_qt: wip
    * calibration file import/export working
    * s1p and s2p export working
2018-03-04 change usb vid/pid
2018-03-27 add enclosure files
    [front_back_panel.fcstd]
2018-03-27 tweak enclosure dimensions
    [front_back_panel.fcstd]
2018-03-27 vna_qt: show available devices under device menu and some other menu fixes
2018-04-04 add UI and framework for inputting cal kit parameters; add touchstone parser
    * still left to be done: actually use the cal kit settings in the
    calibration library
2018-04-05 detect usb serial devices on mac os
2018-04-05 vhdl: cork usb tx until buffer is half full to avoid high cpu consumption on the host
    [top2.vhd]
2018-04-07 libxavna: force thread exit at close() time
2018-04-07 (wip) new calibration library
2018-04-07 Revert "libxavna: force thread exit at close() time"
    This reverts commit 2184a488fb754d009d62e7bce49f03ec21d2470b.
2018-04-07 libxavna: cancel background thread when stopScan() is called
2018-04-07 fix memory error caused by eigen stl specialization
2018-04-08 vna_qt: misc fixes:
    * fix qt dockwidget closing on main window minimize
    * automatically refresh devices menu when it is clicked
    * use icons instead of text symbols on buttons
    * fix a few compiler warnings
2018-04-08 vna_qt: fix QFileDialog filter string in calkitsettingsdialog
2018-04-08 fix formatting of calibration.H
2018-04-08 vna_qt: set application name (fix qsettings on windows)
    [main.C]
2018-04-08 vna_qt: change add button icon size
2018-04-11 pcb: add missing footprint files
2018-04-11 pcb: fix incorrect part number in schematic
    [main2_2.mapping.csv, main2_2.sch]
2018-04-11 deploy_*: don't hardcode paths
    [env.cfg]
2018-04-14 pcb: add main3 (full two port vna) schematic and pcb (wip)
    [main3.pcb, main3.sch]
2018-04-14 pcb: main3: wip
    [main3.pcb, main3.sch]
2018-04-29 pcb: main3: layout design completed
    [main3.pcb, main3.sch]
2018-05-11 pcb: main3: (first production prototype)
    [0402_s.pcb, main3.pcb, main3.sch]
2018-08-16 libxavna: default to T/R mode until proper detection of the device is implemented
2018-08-16 version 3 (full two port) revision 2 pcb
    [main3_2.pcb, main3_2.sch]
2018-08-24 pcb: main3_2: use same dimensions of shield can for both couplers
    [main3_2.pcb, main3_2.sch]
2018-09-08 implement two port SOLT (unknown thru) calibration
2018-09-08 proper support for full two port vna
    -----libxavna-----
    * autodetect device type in libxavna
    * update to newest usb serial data format for full two port
    * allow setting IF frequency
    * allow setting T/R mode and port swapping in c++ api
    -----qt gui-----
    * show all traces in vna_diagtool and allow selecting excitation port
    * allow changing # of datapoints to average over in qt gui device>sweep
    params
    * support changing views between T/R mode and full two port mode
2018-09-08 vhdl_twoport: more config registers; new data format; fix adc clock phase
    * allow selecting filtered & unfiltered adc data output mode (for
    debugging)
    * new data format; handle RFSW_DIR switching in hardware and capture
    values with the switch in both positions, rather than have software
    perform the switching; this allows timing-accurate switching and
    minimizes the effects of drift
    * fix overflow in integrators and filters
    * fix adc sampling clock phase
    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
    [clk_wiz_v3_6_2.vhd, top.vhd, vna_tx_new2.vhd]
2018-09-08 vhdl: adf4350_calc: fix frequency boundary values
    [adf4350_calc.vhd]
2018-09-12 vhdl_twoport: use direct adc data in phase/magnitude detector
    since we have narrowband filter afterwards it makes no difference if
    filtering is done on the input
2018-09-12 libxavna: update baseband sample rate to correctly set IF frequency
    baseband sample rate is now 76.8MHz (19.2MHz x 4)
2018-09-12 libxavna: calibration: add modified unknown thru calibration
2018-09-12 libxavna: calibration: add help text
2018-09-12 vna_qt: add button to show help text for calibration types
2018-09-12 vhdl: increase spi clock speed to 2MHz for faster frequency setting
2018-09-12 vna_qt: add recommended power settings text to sweep params dialog
2019-01-28 pcb: main2_2: modify layout to support bulkhead sma connectors
    [main2_2.pcb, main2_2.sch]
2019-01-28 update some footprints
2019-01-28 pcb: main2_2: remove bottom side gpios to avoid potential esd issues
    [main2_2.pcb, main2_2.sch]
2019-01-28 pcb: main2_2: remove all silkscreen & internal text referencing "xaVNA"
    [main2_2.pcb]
2019-01-29 pcb: main2_2: add more ground pads on sides of pcb
    [main2_2.pcb, main2_2.sch]
2019-02-13 pcb: main2_2: small tweaks to groundplane geometry near coupler
    [main2_2.pcb]
2019-02-13 pcb: fix BOM mappings
    [main2_2.mapping.csv]
2019-02-13 pcb: add BOM mappings for main3_2
    [main3_2.mapping.csv]
2019-02-20 pcb: main2_2: revise some component values
    * buck converter feedback capacitors should be 100pF
    * dc blocking caps all changed to 1nF
    [main2_2.sch]
2019-02-20 pcb: main2_2: remove ground pads on board edges
    avoid repeatability problems related to board making intermittent
    contact with enclosure
    [main2_2.pcb]
2019-04-06 vna_qt: add impedance, capacitance, and inductance graph views
2019-07-10 add missing gschem symbols
    fix #27
    [ada4932-1.csv, adc10065.csv, bgs12pl6.csv, ics511.csv, pl133.csv, rfsw6024.csv]
